ChristianDiazB/SIST.EMBED/evidencias/Arquitectura planteada con sensores y estructura fisica.png

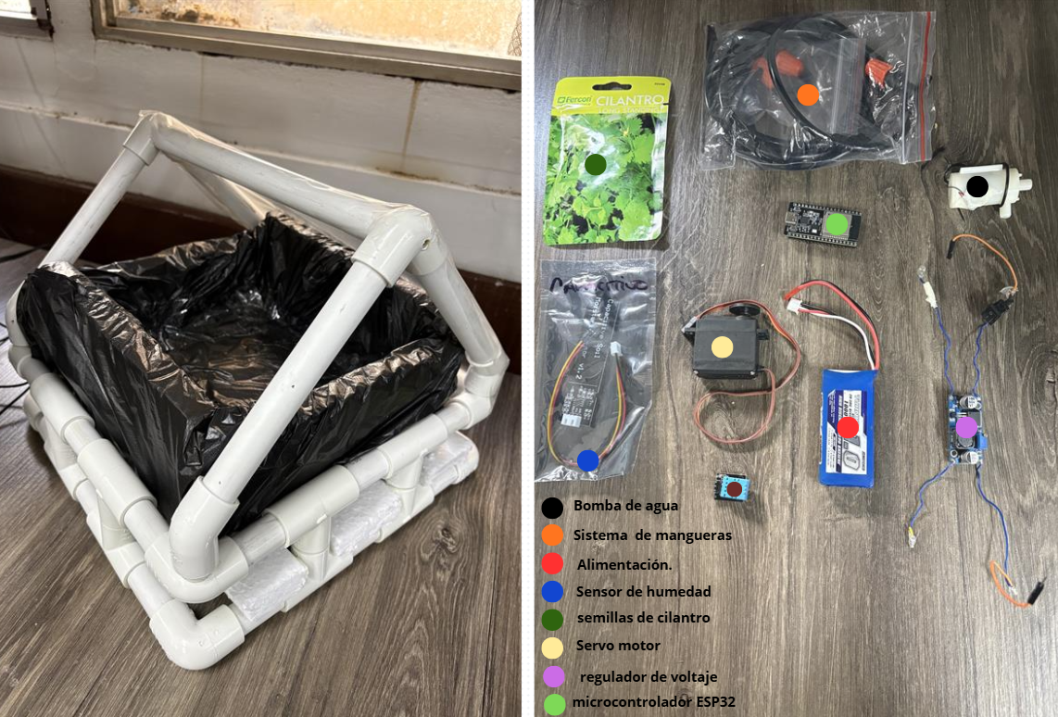
evidencias/Arquitectura planteada con sensores y estructura fisica.png
