ChristianDiazB/SIST.EMBED/README

AGRO MIST G2

Sistema embebido IoT para monitoreo climático,
humectación automatizada y regulación microambiental
en semillero inteligente portable.

Integrantes

- Christian Díaz
- Angélica Cordero

Tecnologías usadas

- ESP32-WROOM
- PlatformIO
- MQTT
- Node-RED
- DHT22
- Sensor capacitivo de humedad

Estructura del proyecto

- `/firmware` → código fuente
- `/docs` → documentación técnica
- `/cad` → planos y renders
- `/bitacora` → registro semanal
- `/evidencias` → capturas y pruebas

Estado actual

En desarrollo
