ChristianDiazB/SIST.EMBED/docs/Presentación Final AGRO_MIST_G2.pdf

## Sistema IoT para Monitoreo y Riego de Hortalizas

Christian Díaz & Angélica Cordero Sistemas Embebidos IoT • 2025

# AGRO_MIST_G2

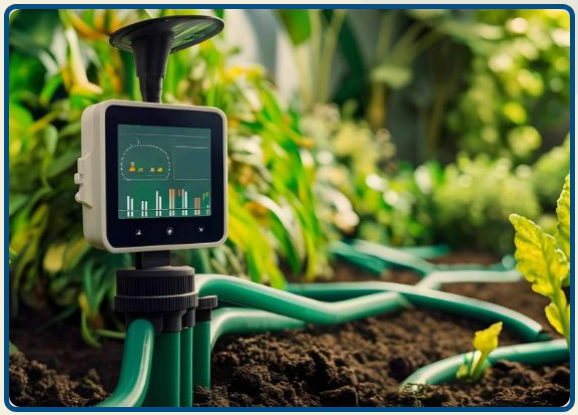
[picture p2: figure]

Desafío: El cultivo de hortalizas en ambientes controlados (semilleros) exige precisión absoluta en microclima.

Solución: Un sistema embebido que centralice percepción, decisión y acción remota.

- Inestabilidad en temperatura y humedad.
- Monitoreo manual ineficiente y tardío.
| automatización.
- Estrés hídrico recurrente por falta de

# Análisis del Problema

# Requisitos y Funcionalidades

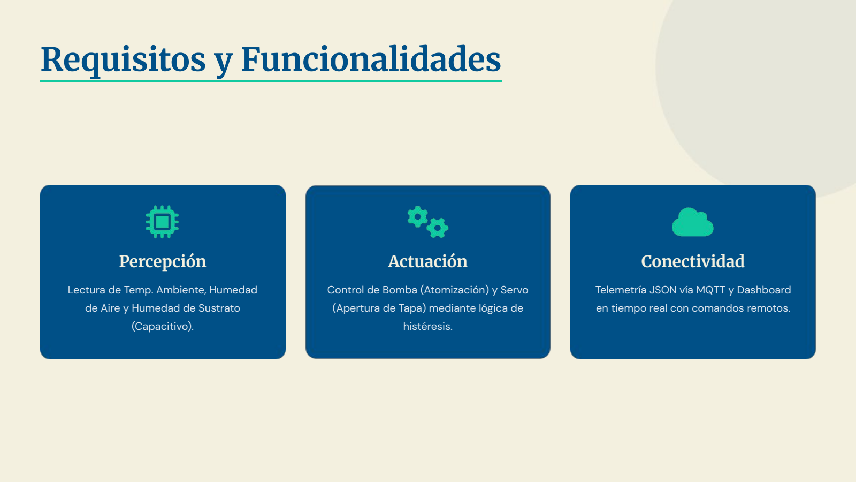
[picture p3: page 3]

Lectura de Temp. Ambiente, Humedad de Aire y Humedad de Sustrato (Capacitivo).

Control de Bomba (Atomización) y Servo (Apertura de Tapa) mediante lógica de histéresis.

Telemetría JSON vía MQTT y Dashboard en tiempo real con comandos remotos.

Percepción | Actuación | Conectividad

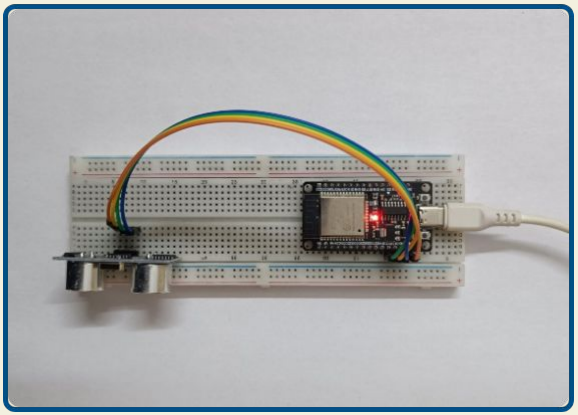
[picture p4: figure]

- Percepción: ESP32-WROOM + DHT22 + Sensor de Suelo.

(HiveMQ Cloud).

- Conectividad: WiFi 2.4GHz + Protocolo MQTT
- Aplicación: Node-RED (Dashboard) para monitoreo y control manual/auto.

# Arquitectura del Sistema

Capas de Implementación

# Hardware y Componentes

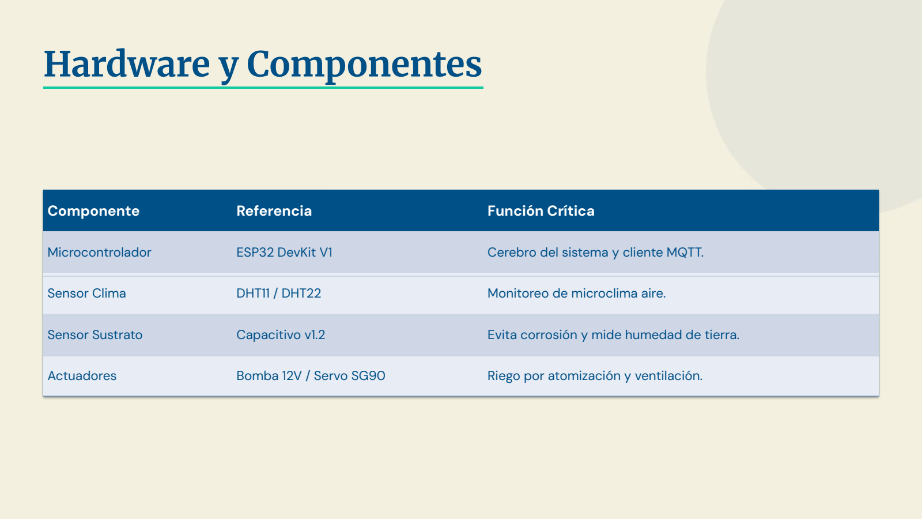
[picture p5: page 5]

Componente | Referencia | Función Crítica
Microcontrolador | ESP32 DevKit V1 | Cerebro del sistema y cliente MQTT.
Sensor Clima | DHT11 / DHT22 | Monitoreo de microclima aire.
Sensor Sustrato | Capacitivo v1.2 | Evita corrosión y mide humedad de tierra.
Actuadores | Bomba 12V / Servo SG90 | Riego por atomización y ventilación.

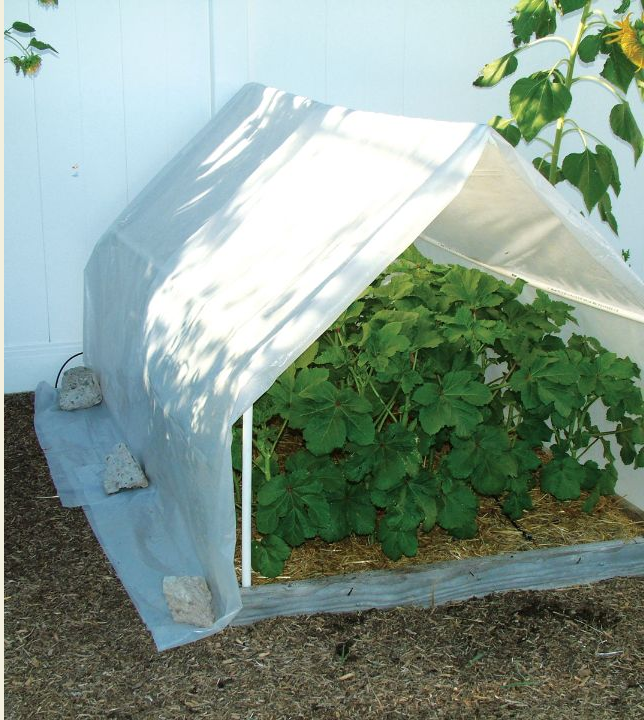
[picture p6: figure]

Prototipo construido en estructura de PVC de 1/2".

- Geometría: Cuadrada 40x40 cm.
- Sustrato: 10 cm de profundidad.
| sistema de filtrado integrado.
| regulación térmica.
- Hidráulica: 3 boquillas atomizadoras con
- Mecánica: Cubierta accionada por servo para

# Diseño Físico

Estructura Portable

- Framework: VS Code + PlatformIO.
- Comms: PubSubClient para MQTT asíncrono.
| en el stack WiFi.
- Watchdog: Implementado para evitar bloqueos

# Firmware y Lógica de Control

Desarrollo Modular

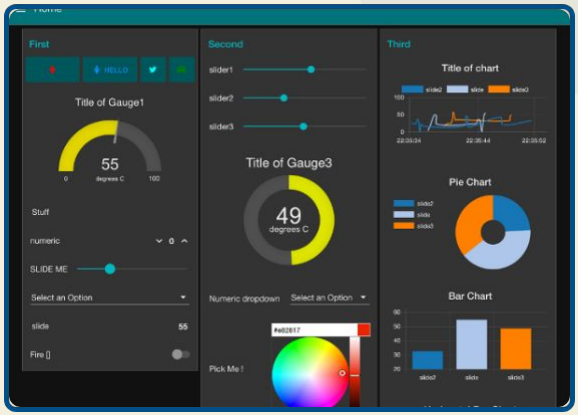
[picture p7: figure]

- Group 1: Control Manual (Switches).
- Group 2: Métricas (Gauges en tiempo real).
- Group 3: Alarmas y Estados (LEDs).
| críticos.
- Alertas: Notificación por Email ante eventos

# Solución IoT y Dashboard

Node-RED Flow

# Resultados Obtenidos

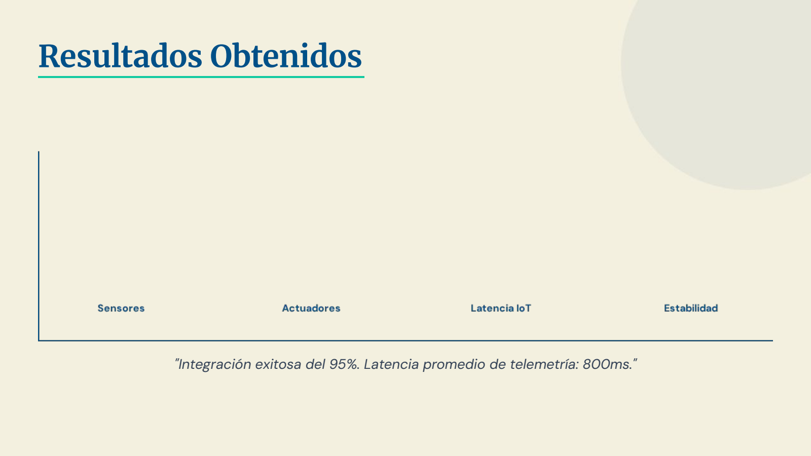
[picture p8: page 9]

"Integración exitosa del 95%. Latencia promedio de telemetría: 800ms."

- Persistencia: Los datos se pierden al reiniciar Node-RED.
- Broker: Dependencia de conectividad a la nube.
- Calibración: Curva del sensor de suelo empírica.
- Base de Datos: Integrar InfluxDB + Grafana.
- Edge AI: Predicción de riego basada en clima histórico.
- App: Desarrollo de aplicación móvil nativa.

# Limitaciones y Trabajo Futuro

Limitaciones | Próximos Pasos

# Lecciones Aprendidas

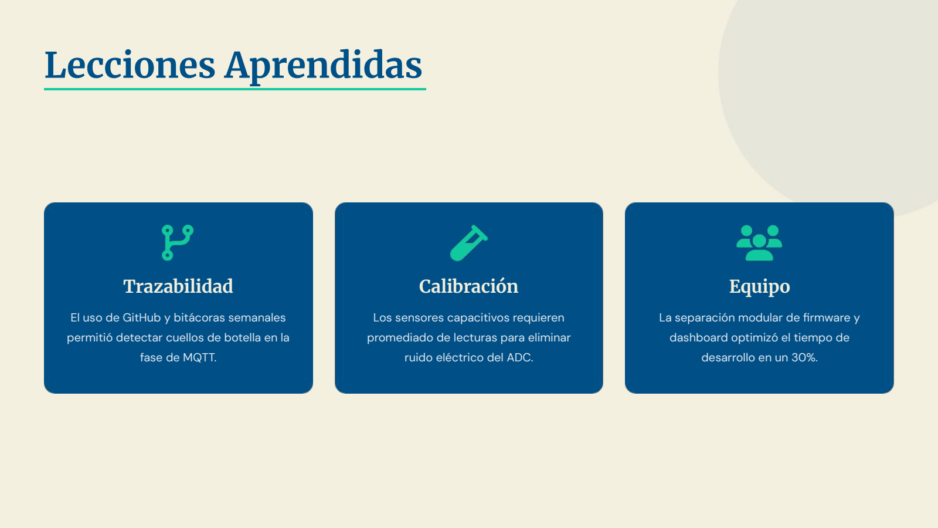
[picture p9: page 11]

El uso de GitHub y bitácoras semanales permitió detectar cuellos de botella en la fase de MQTT.

Los sensores capacitivos requieren promediado de lecturas para eliminar ruido eléctrico del ADC.

La separación modular de firmware y dashboard optimizó el tiempo de desarrollo en un 30%.

Trazabilidad | Calibración | Equipo

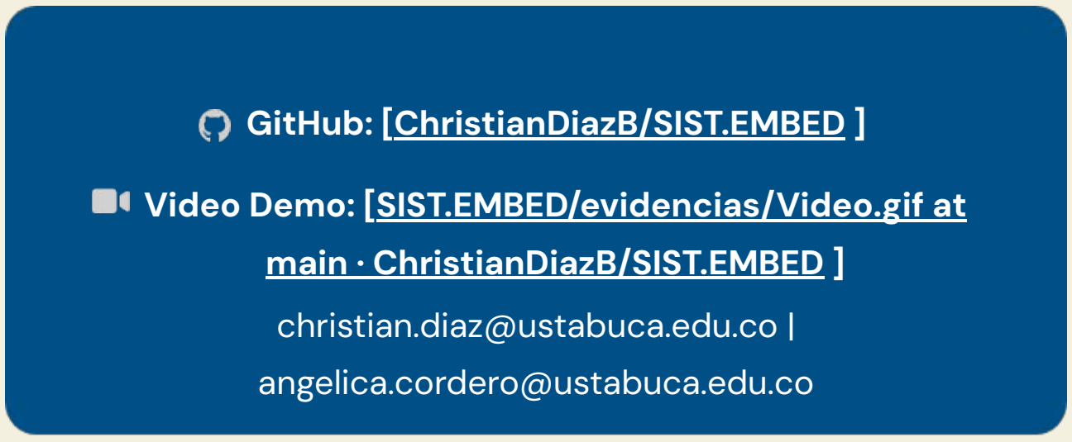
[picture p10: figure]
GitHub: [ChristianDiazB/SIST.EMBED ]; main · ChristianDiazB/SIST.EMBED ]; christian.diaz@ustabuca.edu.co | angelica.cordero@ustabuca.edu.co

¡Gracias por su atención!

Video Demo: [SIST.EMBED/evidencias/Video.gif at

# ¿Preguntas?

https://forwardfooding.com/wp-content/uploads/2025/09/Smart-Irrigation-Systems-scaled-1-scaled-e1731315114263.jpeg
Source: forwardfooding.com

https://content.instructables.com/FFQ/NYCY/MIRS92L0/FFQNYCYMIRS92L0.jpg
Source: www.instructables.com

http://ogden_images.s3.amazonaws.com/www.grit.com/images/2023/09/01092509/PVC-aA-frame-cold-frame.jpg
Source: www.grit.com

http://nodered.org/images/dashboarde.png
Source: flows.nodered.org

# Image Sources
