ChristianDiazB/SIST.EMBED/evidencias/Dashboard nodered.jpg

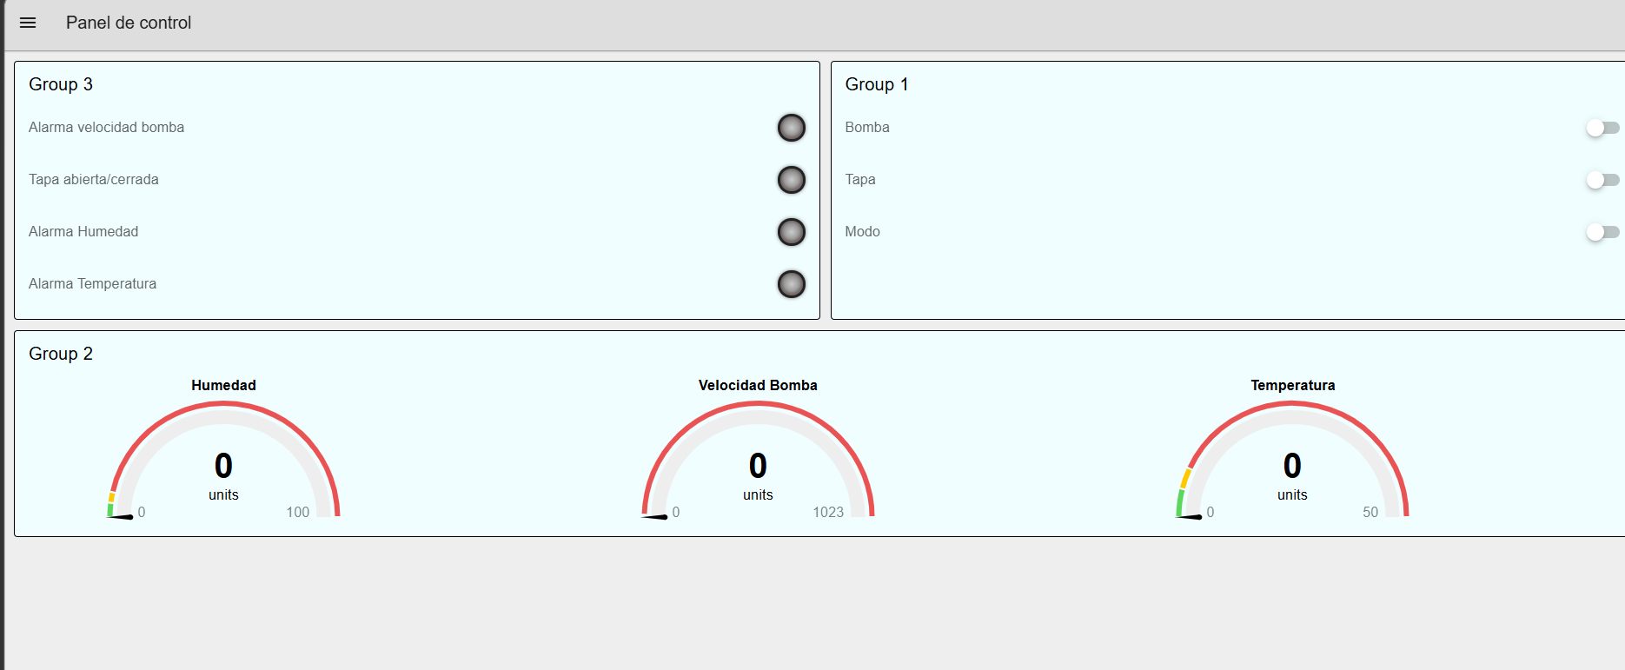
evidencias/Dashboard nodered.jpg
