ChristianDiazB/SIST.EMBED/evidencias/Flujo node red.jpg

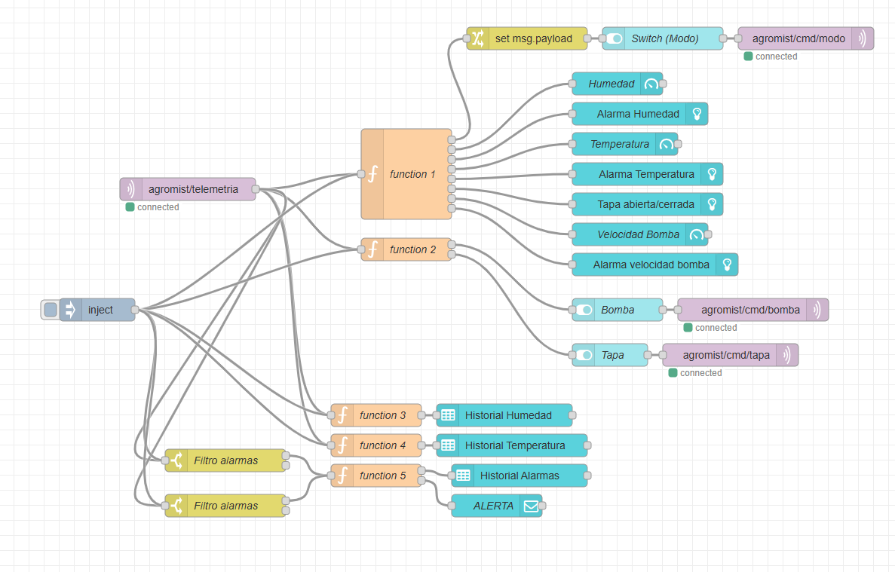
evidencias/Flujo node red.jpg
