ChristianDiazB/SIST.EMBED/evidencias/Evidencia funcionamiento comunicacion de prueba esp32-hivemq-nodered.png

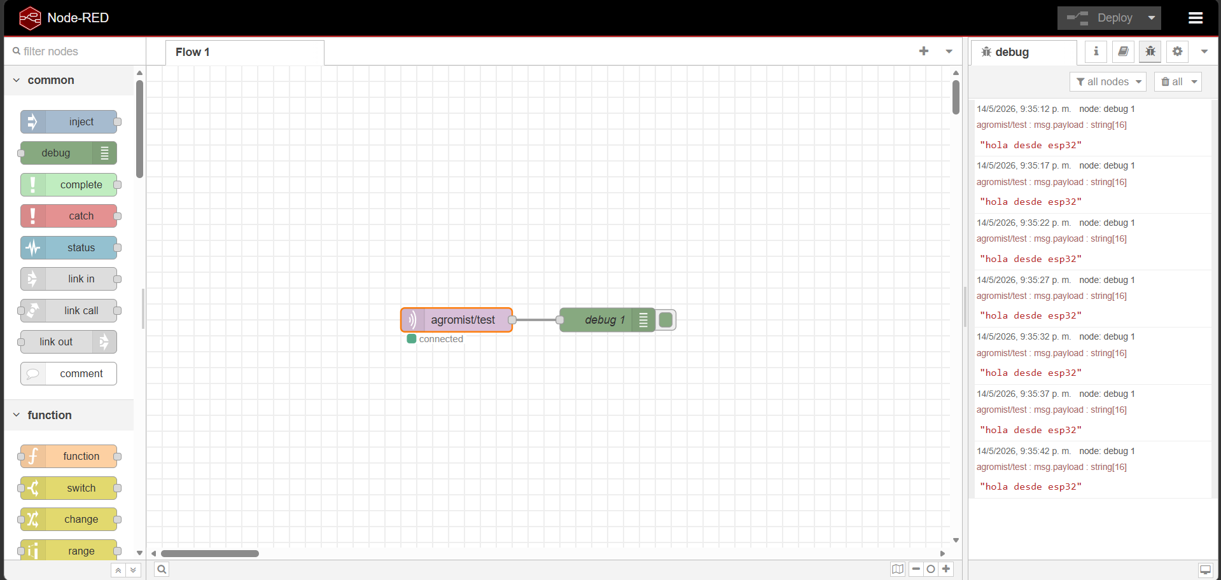
evidencias/Evidencia funcionamiento comunicacion de prueba esp32-hivemq-nodered.png
