ChristianDiazB/SIST.EMBED/(commit log)

2026-05-15 Organizacion de estructura y documentacion inicial
2026-05-15 Eliminacion de archivos compilados .pio
2026-05-15 Actualizacion Firmware prueba de funcionamiento del dht11
2026-05-15 Actualizacion de evidencias con arquitectura planteada
2026-05-15 Actualizacion de firmare prueba de comunicacion mqtt
2026-05-30 Rename WhatsApp Video 2026-05-28 at 7.52.54 PM.mp4 to Video de prueba
2026-05-30 Create Flow
2026-05-30 Rename flows (1).json to Flow
2026-05-30 Rename Captura de pantalla 2026-05-29 191458.png to Flujo node red
2026-05-30 Rename Captura de pantalla 2026-05-29 191510.png to Dashboard nodered
2026-05-30 Rename Video de prueba to Video de prueba.mp4
2026-05-30 Rename Video de prueba.mp4 to Video de prueba.gif
2026-05-30 Rename WhatsApp Video 2026-05-28 at 7.52.54 PM.gif to Video de prueba.gif
2026-05-30 Add new video file 'Video de prueba PM.gif'
